jamiecheng/dab-radio-alarm/hardware/dab-radio-alarm.kicad_pcb

## KiCad design hardware/dab-radio-alarm.kicad_pcb (2023-07-09)

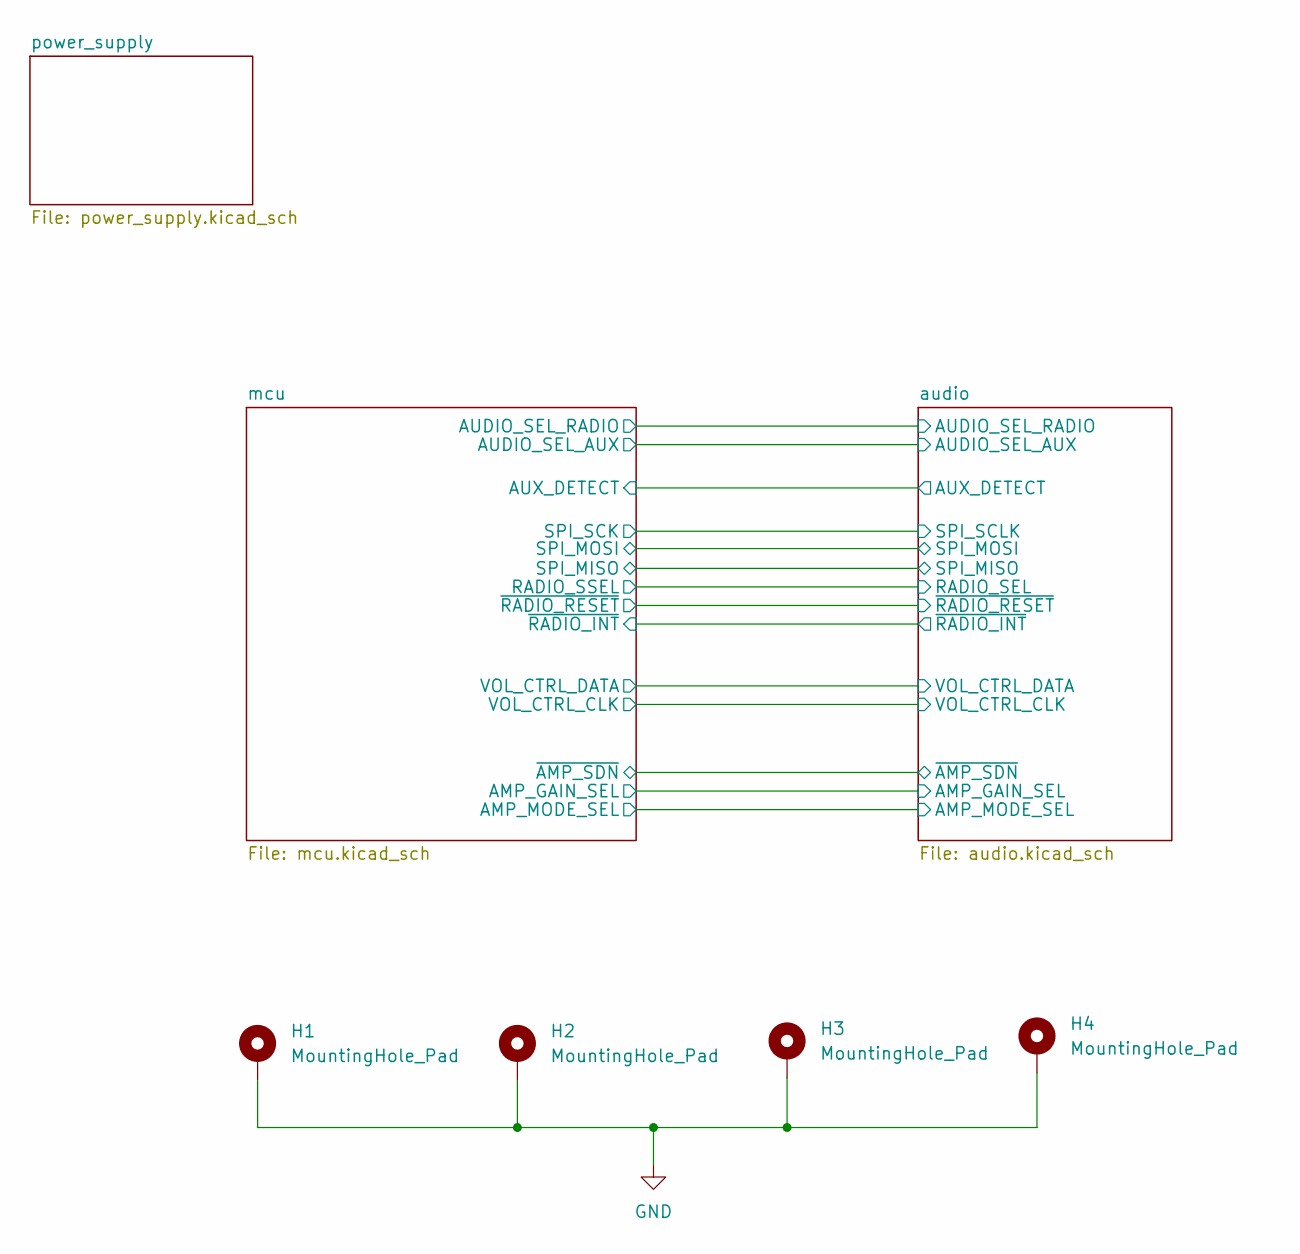
[picture p1: schematic dab-radio-alarm.kicad_sch]

Parts:
H1, H2, H3, H4: MountingHole_Pad; MountingHole_3.2mm_M3_Pad_Via

Connections:
GND: H1.1, H2.1, H3.1, H4.1; also elsewhere on the board

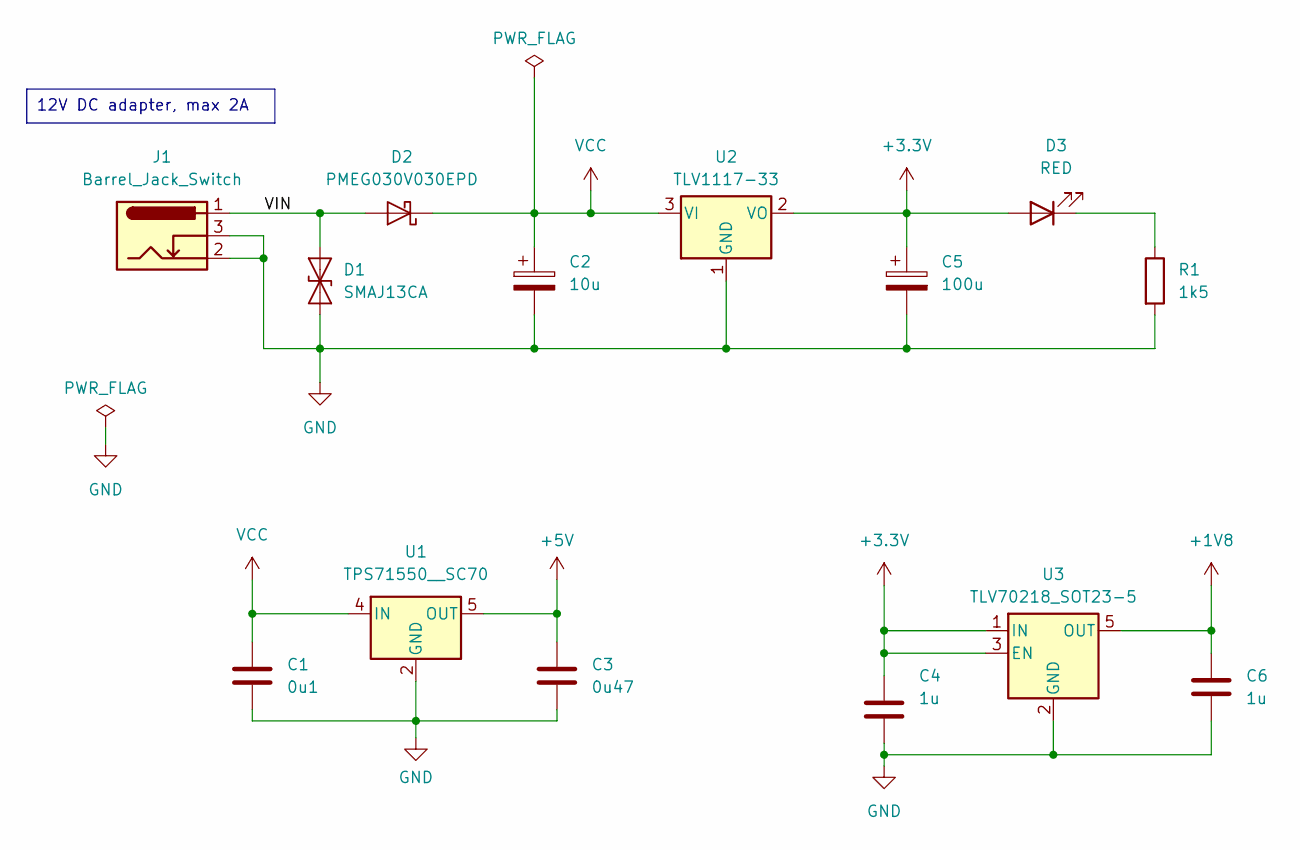
[picture p2: schematic power_supply.kicad_sch]

Parts:
C1: 0u1; C_0603_1608Metric
C2: 10u; CP_Elec_6.3x5.4
C3: 0u47; C_0402_1005Metric
C4, C6: 1u; C_0402_1005Metric
C5: 100u; CP_Elec_8x10
D1: SMAJ13CA; D_SMA
D2: PMEG030V030EPD; Nexperia_CFP15_SOT-1289
D3: RED; LED_0603_1608Metric
J1: Barrel_Jack_Switch; BarrelJack_GCT_DCJ200-10-A_Horizontal
R1: 1k5; R_0402_1005Metric
U1: TPS71550__SC70; SOT-353_SC-70-5
U2: TLV1117-33; SOT-223-3_TabPin2
U3: TLV70218_SOT23-5; SOT-23-5

Connections:
+1V8: C6.1, U3.5 (OUT); also elsewhere on the board
+3.3V: C4.1, C5.1, D3.2 (A), U2.2 (VO), U3.1 (IN), U3.3 (EN); also elsewhere on the board
+5V: C3.1, U1.5 (OUT); also elsewhere on the board
/power_supply/VIN: D1.1 (A1), D2.1 (A), D2.2 (A), J1.1
GND: C1.2, C2.2, C3.2, C4.2, C5.2, C6.2, D1.2 (A2), J1.2, J1.3, R1.2, U1.2 (GND), U2.1 (GND), U3.2 (GND); also elsewhere on the board
unnamed: D3.1 (K), R1.1
VCC: C1.1, C2.1, D2.3 (K), U1.4 (IN), U2.3 (VI); also elsewhere on the board

Notes on the sheet:
12V DC adapter, max 2A

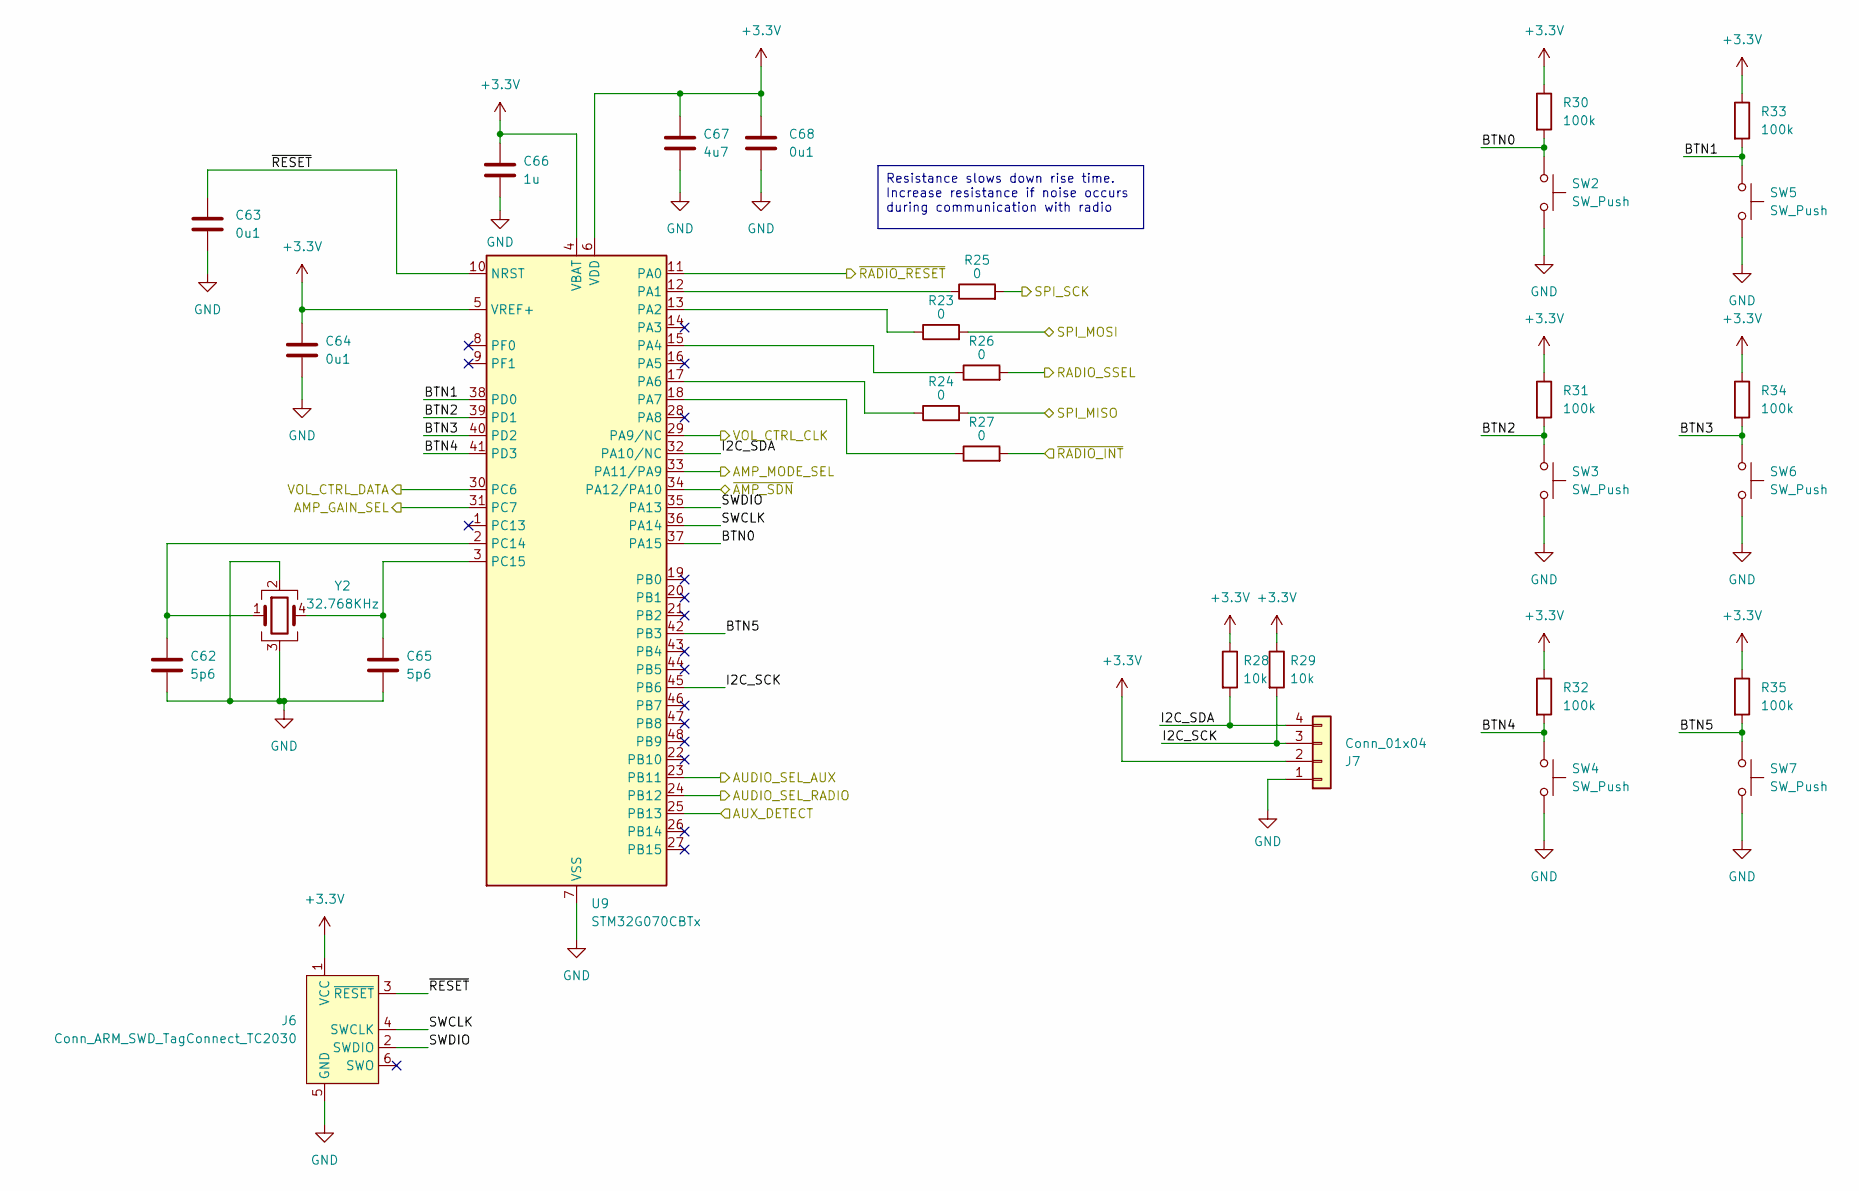
[picture p3: schematic mcu.kicad_sch]

Parts:
C62, C65: 5p6; C_0402_1005Metric
C63, C64, C68: 0u1; C_0402_1005Metric
C66: 1u; C_0402_1005Metric
C67: 4u7; C_0603_1608Metric
J6: Conn_ARM_SWD_TagConnect_TC2030; Tag-Connect_TC2030-IDC-FP_2x03_P1.27mm_Vertical
J7: Conn_01x04; PinHeader_1x04_P2.54mm_Vertical
R23, R24, R25, R26, R27: 0; R_0402_1005Metric
R28, R29: 10k; R_0402_1005Metric
R30, R31, R32, R33, R34, R35: 100k; R_0402_1005Metric
SW2, SW3, SW4, SW5, SW6, SW7: SW_Push; SW_PUSH_6mm_H5mm
U9: STM32G070CBTx; LQFP-48_7x7mm_P0.5mm
Y2: 32.768KHz; Crystal_SMD_3225-4Pin_3.2x2.5mm

Connections:
+3.3V: C64.1, C66.1, C67.1, C68.1, J6.1 (VCC), J7.2, R28.1, R29.1, R30.1, R31.1, R32.1, R33.1, R34.1, R35.1, U9.4 (VBAT), U9.5 (VREF+), U9.6 (VDD); also elsewhere on the board
/audio/AMP_GAIN_SEL: U9.31 (PC7); also elsewhere on the board
/audio/AMP_MODE_SEL: U9.33 (PA11/PA9); also elsewhere on the board
/audio/AUDIO_SEL_AUX: U9.23 (PB11); also elsewhere on the board
/audio/AUDIO_SEL_RADIO: U9.24 (PB12); also elsewhere on the board
/audio/AUX_DETECT: U9.25 (PB13); also elsewhere on the board
/audio/RADIO_SEL: R26.2; also elsewhere on the board
/audio/SPI_MISO: R24.2; also elsewhere on the board
/audio/SPI_MOSI: R23.2; also elsewhere on the board
/audio/SPI_SCLK: R25.2; also elsewhere on the board
/audio/VOL_CTRL_CLK: U9.29 (PA9/NC); also elsewhere on the board
/audio/VOL_CTRL_DATA: U9.30 (PC6); also elsewhere on the board
/audio/~AMP_SDN: U9.34 (PA12/PA10); also elsewhere on the board
/audio/~RADIO_INT: R27.2; also elsewhere on the board
/audio/~RADIO_RESET: U9.11 (PA0); also elsewhere on the board
/mcu/BTN0: R30.2, SW2.1, U9.37 (PA15)
/mcu/BTN1: R33.2, SW5.1, U9.38 (PD0)
/mcu/BTN2: R31.2, SW3.1, U9.39 (PD1)
/mcu/BTN3: R34.2, SW6.1, U9.40 (PD2)
/mcu/BTN4: R32.2, SW4.1, U9.41 (PD3)
/mcu/BTN5: R35.2, SW7.1, U9.42 (PB3)
/mcu/I2C_SCK: J7.3, R29.2, U9.45 (PB6)
/mcu/I2C_SDA: J7.4, R28.2, U9.32 (PA10/NC)
/mcu/SWCLK: J6.4 (SWCLK), U9.36 (PA14)
/mcu/SWDIO: J6.2 (SWDIO), U9.35 (PA13)
/mcu/~RESET: C63.1, J6.3 (~RESET), U9.10 (NRST)
GND: C62.2, C63.2, C64.2, C65.2, C66.2, C67.2, C68.2, J6.5 (GND), J7.1, SW2.2, SW3.2, SW4.2, SW5.2, SW6.2, SW7.2, U9.7 (VSS), Y2.2, Y2.3; also elsewhere on the board
unnamed: R25.1, U9.12 (PA1)
unnamed: R23.1, U9.13 (PA2)
unnamed: R26.1, U9.15 (PA4)
unnamed: R24.1, U9.17 (PA6)
unnamed: R27.1, U9.18 (PA7)
unnamed: C62.1, U9.2 (PC14), Y2.1
unnamed: C65.1, U9.3 (PC15), Y2.4

Notes on the sheet:
Resistance slows down rise time. Increase resistance if noise occurs during communication with radio

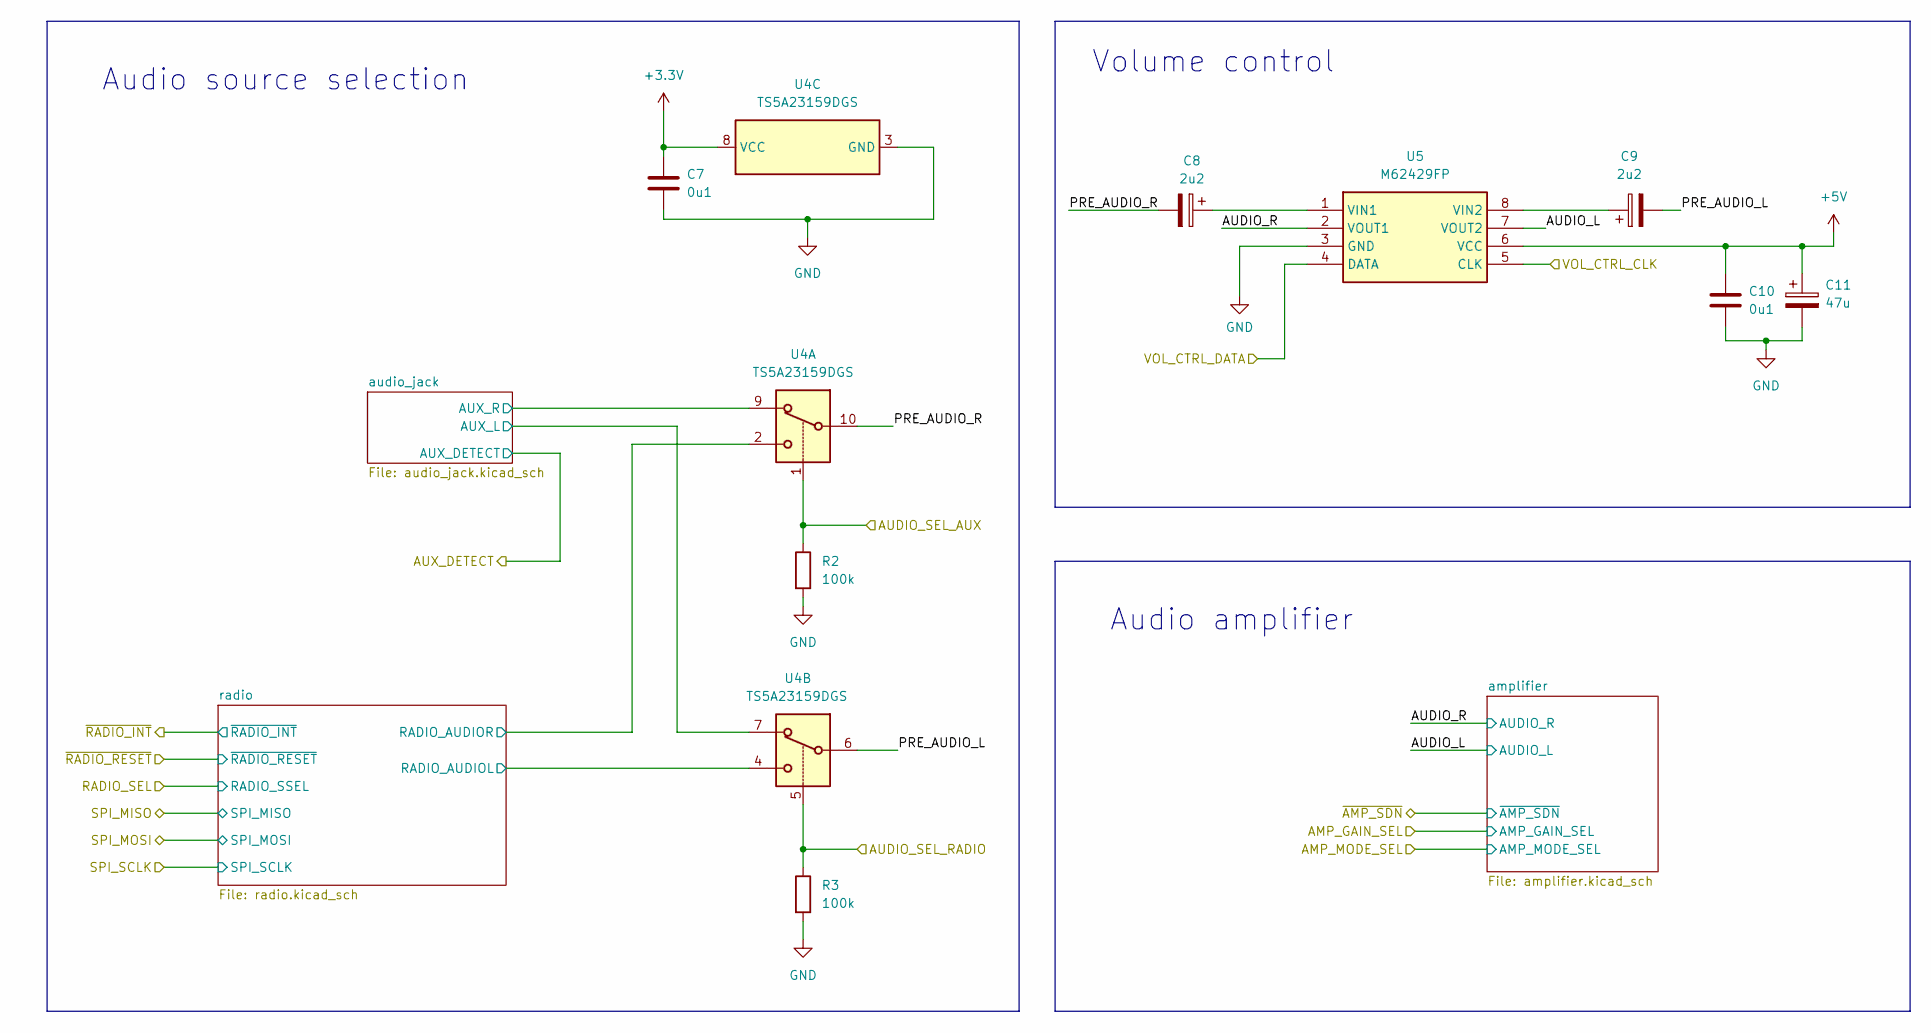
[picture p4: schematic audio.kicad_sch]

Parts:
C7, C10: 0u1; C_0402_1005Metric
C8, C9: 2u2; CP_Elec_4x5.4
C11: 47u; CP_Elec_5x5.4
R2, R3: 100k; R_0402_1005Metric
U4: TS5A23159DGS; VSSOP-10_3x3mm_P0.5mm
U5: M62429FP; SOP-8_3.9x4.9mm_P1.27mm; Manufacturer_Part_Number M62429FP

Connections:
+3.3V: C7.1, U4.8 (VCC); also elsewhere on the board
+5V: C10.1, C11.1, U5.6 (VCC); also elsewhere on the board
/audio/AUDIO_L: U5.7 (VOUT2); also elsewhere on the board
/audio/AUDIO_R: U5.2 (VOUT1); also elsewhere on the board
/audio/AUDIO_SEL_AUX: R2.1, U4.1; also elsewhere on the board
/audio/AUDIO_SEL_RADIO: R3.1, U4.5; also elsewhere on the board
/audio/PRE_AUDIO_L: C9.2, U4.6
/audio/PRE_AUDIO_R: C8.2, U4.10
/audio/VOL_CTRL_CLK: U5.5 (CLK); also elsewhere on the board
/audio/VOL_CTRL_DATA: U5.4 (DATA); also elsewhere on the board
/audio/audio_jack/AUX_L: U4.7; also elsewhere on the board
/audio/audio_jack/AUX_R: U4.9; also elsewhere on the board
/audio/radio/RADIO_AUDIOL: U4.4; also elsewhere on the board
/audio/radio/RADIO_AUDIOR: U4.2; also elsewhere on the board
GND: C7.2, C10.2, C11.2, R2.2, R3.2, U4.3 (GND), U5.3 (GND); also elsewhere on the board
unnamed: C8.1, U5.1 (VIN1)
unnamed: C9.1, U5.8 (VIN2)

Notes on the sheet:
Volume control
Audio amplifier
Audio source selection

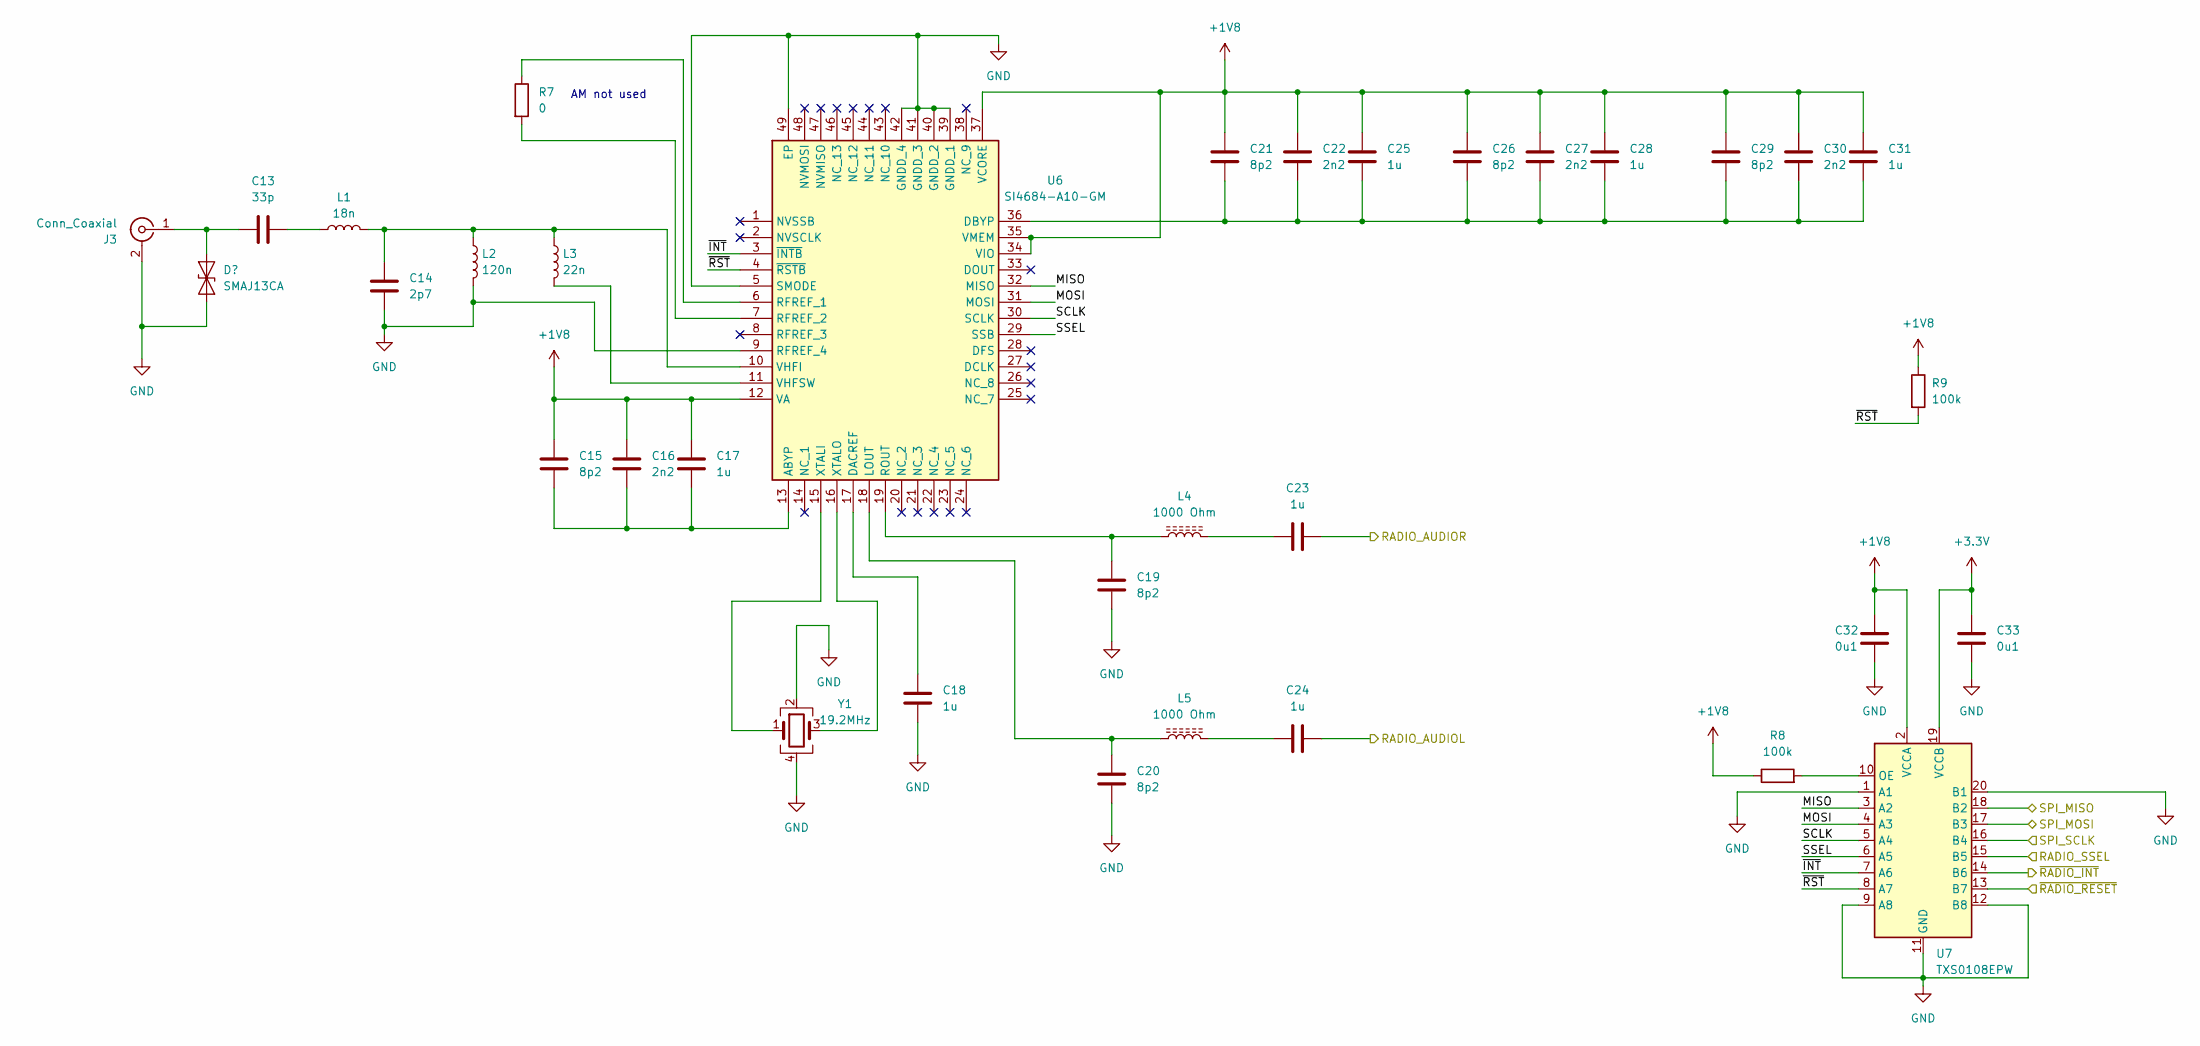
[picture p5: schematic radio.kicad_sch]

Parts:
C13: 33p; C_0402_1005Metric
C14: 2p7; C_0402_1005Metric
C15, C19, C20, C21, C26, C29: 8p2; C_0402_1005Metric
C16, C22, C27, C30: 2n2; C_0402_1005Metric
C17, C18, C23, C24, C25, C28, C31: 1u; C_0402_1005Metric
C32, C33: 0u1; C_0402_1005Metric
D7: SMAJ13CA; D_SMA
J3: Conn_Coaxial; SMA_Molex_73251-1153_EdgeMount_Horizontal
L1: 18n; L_0402_1005Metric
L2: 120n; L_0402_1005Metric
L3: 22n; L_0402_1005Metric
L4, L5: 1000 Ohm; L_0402_1005Metric
R7: 0; R_0402_1005Metric
R8, R9: 100k; R_0402_1005Metric
U6: SI4684-A10-GM; NXP_LQFN-48-1EP_7x7mm_P0.5mm_EP3.5x3.5mm_16xMask0.45x0.45; Manufacturer_Part_Number SI4684-A10-GM; Mouser Part Number 634-SI4684-A10-GM
U7: TXS0108EPW; TSSOP-20_4.4x6.5mm_P0.65mm
Y1: 19.2MHz; Crystal_SMD_EuroQuartz_MT-4Pin_3.2x2.5mm

Connections:
+1V8: C15.1, C16.1, C17.1, C21.1, C22.1, C25.1, C26.1, C27.1, C28.1, C29.1, C30.1, C31.1, C32.1, R8.1, R9.1, U6.12 (VA), U6.34 (VIO), U6.35 (VMEM), U6.37 (VCORE), U7.2 (VCCA); also elsewhere on the board
+3.3V: C33.1, U7.19 (VCCB); also elsewhere on the board
/audio/RADIO_SEL: U7.15 (B5); also elsewhere on the board
/audio/SPI_MISO: U7.18 (B2); also elsewhere on the board
/audio/SPI_MOSI: U7.17 (B3); also elsewhere on the board
/audio/SPI_SCLK: U7.16 (B4); also elsewhere on the board
/audio/radio/MISO: U6.32 (MISO), U7.3 (A2)
/audio/radio/MOSI: U6.31 (MOSI), U7.4 (A3)
/audio/radio/RADIO_AUDIOL: C24.2; also elsewhere on the board
/audio/radio/RADIO_AUDIOR: C23.2; also elsewhere on the board
/audio/radio/SCLK: U6.30 (SCLK), U7.5 (A4)
/audio/radio/SSEL: U6.29 (SSB), U7.6 (A5)
/audio/radio/~INT: U6.3 (~INTB), U7.7 (A6)
/audio/radio/~RST: R9.2, U6.4 (~RSTB), U7.8 (A7)
/audio/~RADIO_INT: U7.14 (B6); also elsewhere on the board
/audio/~RADIO_RESET: U7.13 (B7); also elsewhere on the board
GND: C14.2, C18.2, C19.2, C20.2, C32.2, C33.2, D7.2 (A2), J3.2 (Ext), L2.2, U6.5 (SMODE), U6.9 (RFREF_4), U6.39 (GNDD_1), U6.40 (GNDD_2), U6.41 (GNDD_3), U6.42 (GNDD_4), U6.49 (EP), U7.1 (A1), U7.9 (A8), U7.11 (GND), U7.12 (B8), U7.20 (B1), Y1.2, Y1.4; also elsewhere on the board
unnamed: C13.2, L1.1
unnamed: C23.1, L4.2
unnamed: C24.1, L5.2
unnamed: C13.1, D7.1 (A1), J3.1 (In)
unnamed: C15.2, C16.2, C17.2, U6.13 (ABYP)
unnamed: C18.1, U6.17 (DACREF)
unnamed: C21.2, C22.2, C25.2, C26.2, C27.2, C28.2, C29.2, C30.2, C31.2, U6.36 (DBYP)
unnamed: C20.1, L5.1, U6.18 (LOUT)
unnamed: R7.1, U6.6 (RFREF_1)
unnamed: R7.2, U6.7 (RFREF_2)
unnamed: C19.1, L4.1, U6.19 (ROUT)
unnamed: C14.1, L1.2, L2.1, L3.1, U6.10 (VHFI)
unnamed: L3.2, U6.11 (VHFSW)
unnamed: U6.15 (XTALI), Y1.1
unnamed: U6.16 (XTALO), Y1.3
unnamed: R8.2, U7.10 (OE)

Notes on the sheet:
AM not used

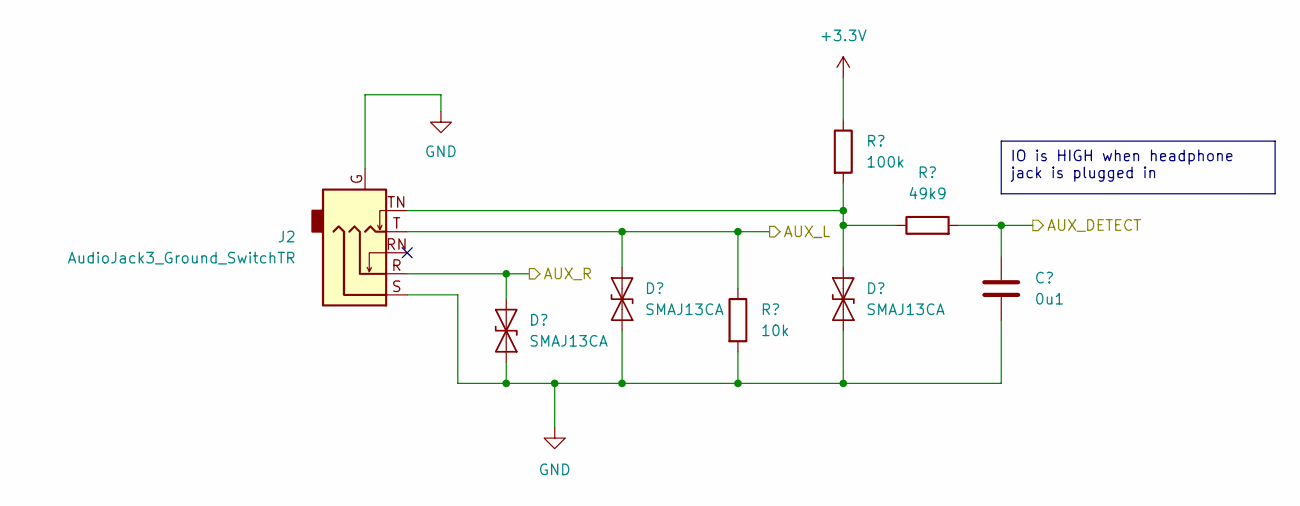
[picture p6: schematic audio_jack.kicad_sch]

Parts:
C12: 0u1; C_0402_1005Metric
D4, D5, D6: SMAJ13CA; D_SMA
J2: AudioJack3_Ground_SwitchTR; Jack_3.5mm_PJ31060-I_Horizontal_1
R4: 10k; R_0402_1005Metric
R5: 100k; R_0402_1005Metric
R6: 49k9; R_0402_1005Metric

Connections:
+3.3V: R5.1; also elsewhere on the board
/audio/AUX_DETECT: C12.1, R6.2; also elsewhere on the board
/audio/audio_jack/AUX_L: D5.1 (A1), J2.T, R4.1; also elsewhere on the board
/audio/audio_jack/AUX_R: D4.1 (A1), J2.R; also elsewhere on the board
GND: C12.2, D4.2 (A2), D5.2 (A2), D6.2 (A2), J2.G, J2.S, R4.2; also elsewhere on the board
unnamed: D6.1 (A1), J2.TN, R5.2, R6.1

Notes on the sheet:
IO is HIGH when headphone jack is plugged in

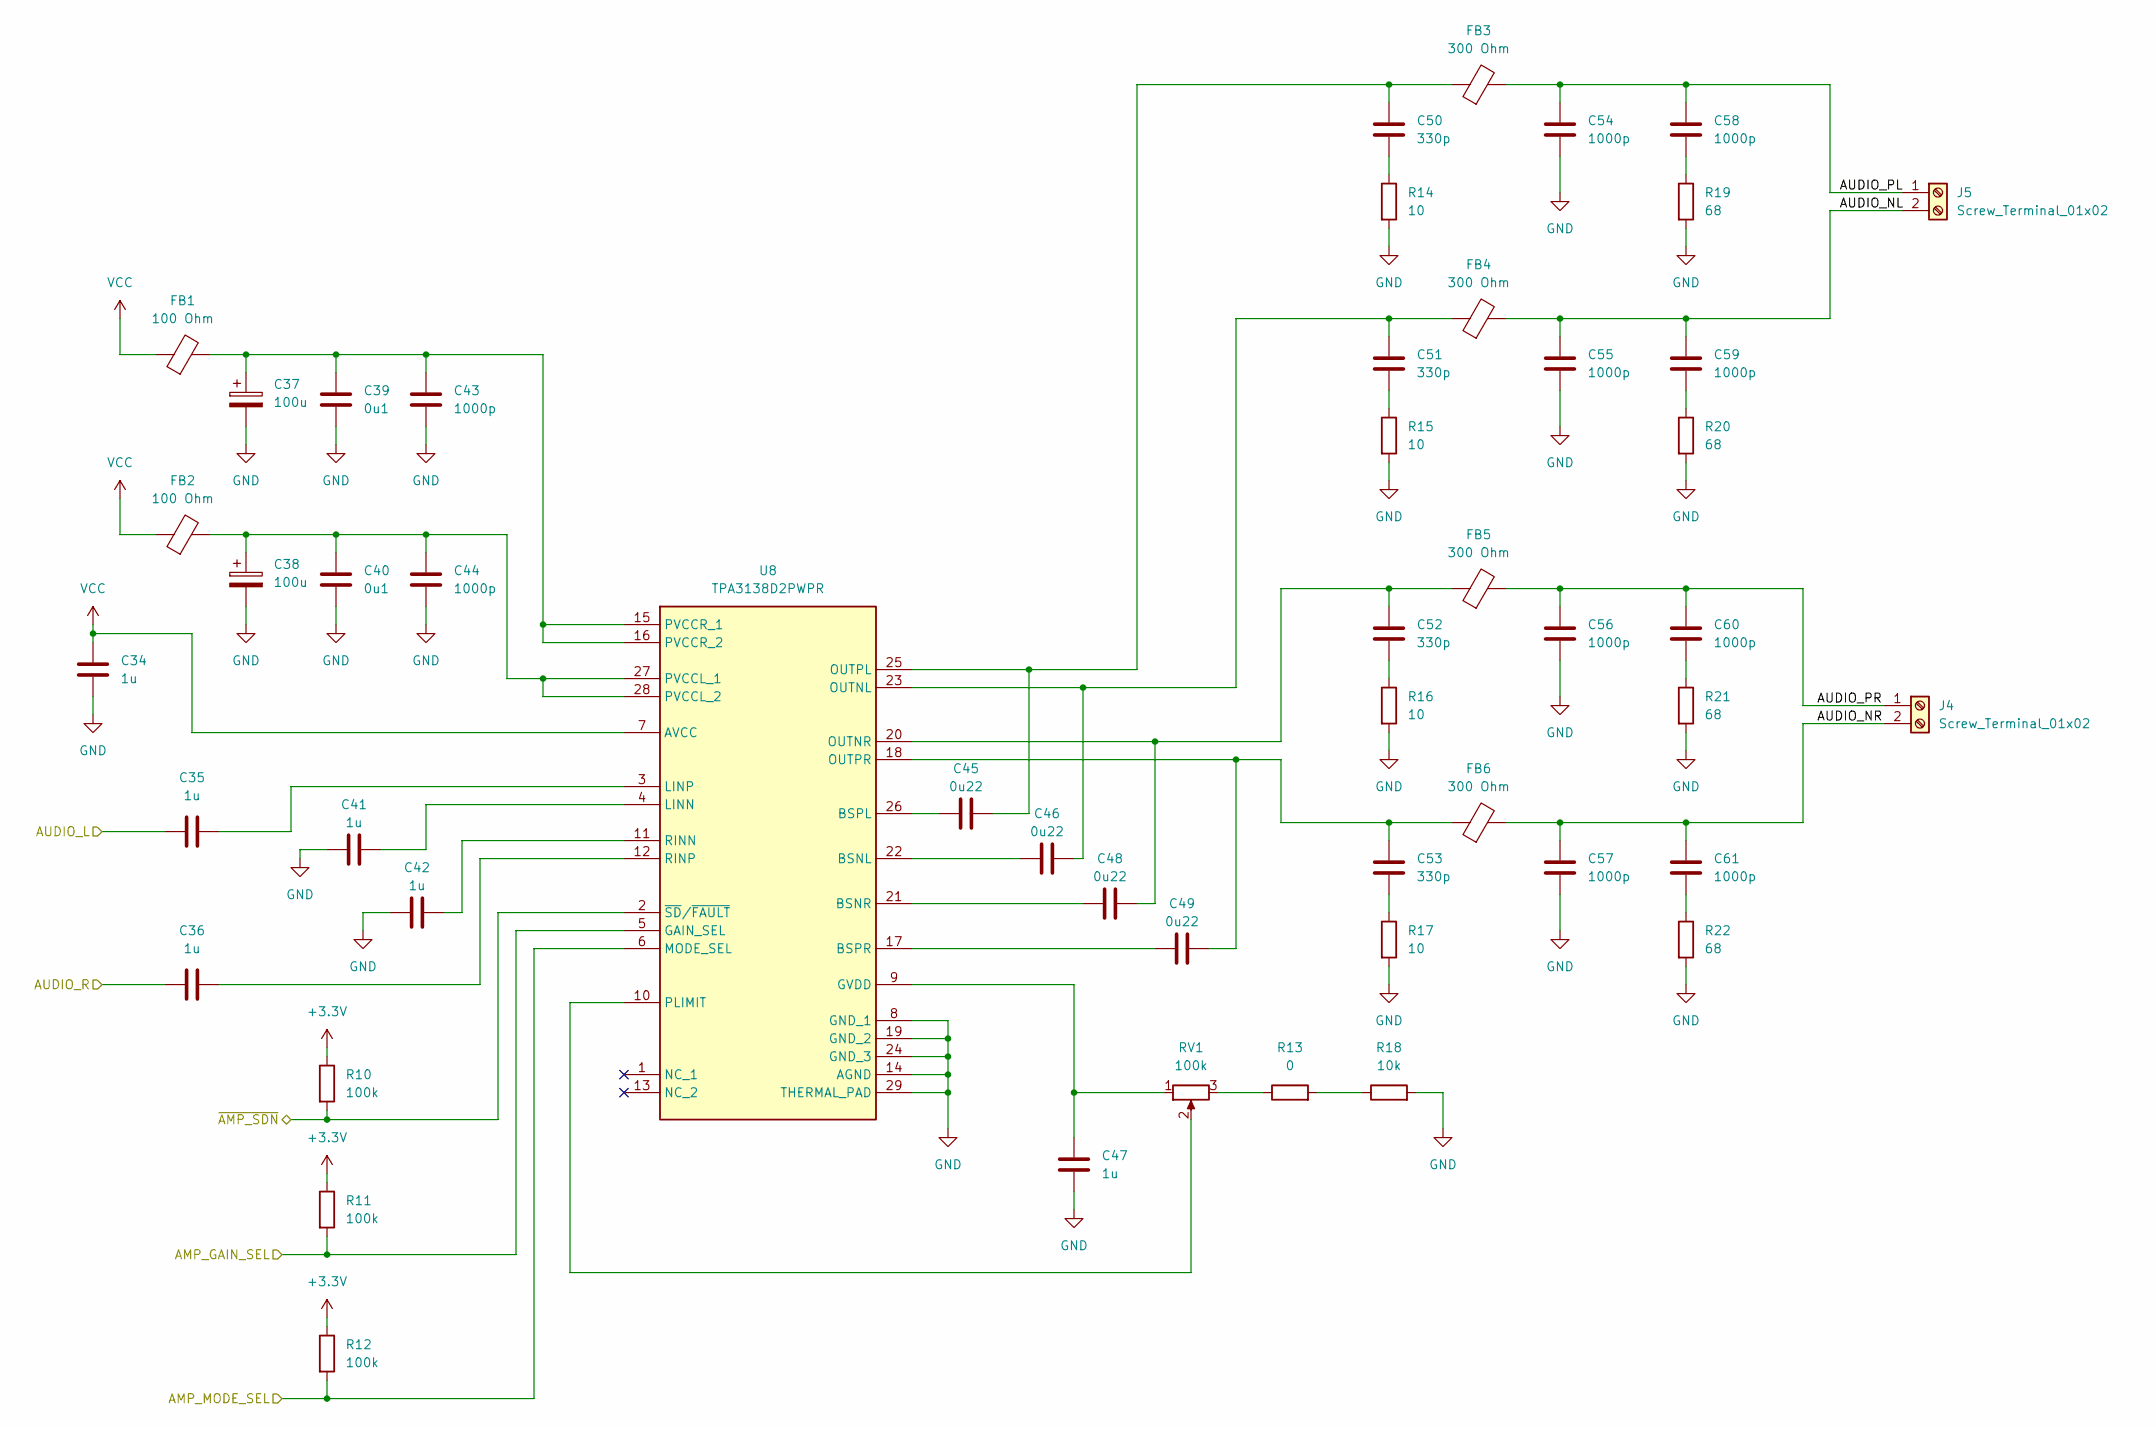
[picture p7: schematic amplifier.kicad_sch]

Parts:
C34, C35, C36, C41, C42, C47: 1u; C_0603_1608Metric
C37, C38: 100u; CP_Elec_8x10
C39, C40: 0u1; C_0603_1608Metric
C43, C44, C54, C55, C56, C57, C58, C59, C60, C61: 1000p; C_0603_1608Metric
C45, C46, C48, C49: 0u22; C_0603_1608Metric
C50, C51, C52, C53: 330p; C_0603_1608Metric
FB1, FB2: 100 Ohm; L_0805_2012Metric
FB3, FB4, FB5, FB6: 300 Ohm; L_0805_2012Metric
J4, J5: Screw_Terminal_01x02; TerminalBlock_MetzConnect_Type011_RT05502HBWC_1x02_P5.00mm_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
R10, R11, R12: 100k; R_0402_1005Metric
R13: 0; R_0402_1005Metric
R14, R15, R16, R17: 10; R_0603_1608Metric
R18: 10k; R_0402_1005Metric
R19, R20, R21, R22: 68; R_0603_1608Metric
RV1: 100k; Potentiometer_Bourns_3314G_Vertical
U8: TPA3138D2PWPR; HTSSOP-28-1EP_4.4x9.7mm_P0.65mm_EP2.85x5.4mm_ThermalVias; Manufacturer_Part_Number TPA3138D2PWPR; Mouser Part Number 595-TPA3138D2PWPR

Connections:
+3.3V: R10.1, R11.1, R12.1; also elsewhere on the board
/audio/AMP_GAIN_SEL: R11.2, U8.5 (GAIN_SEL); also elsewhere on the board
/audio/AMP_MODE_SEL: R12.2, U8.6 (MODE_SEL); also elsewhere on the board
/audio/AUDIO_L: C35.1; also elsewhere on the board
/audio/AUDIO_R: C36.1; also elsewhere on the board
/audio/amplifier/AUDIO_NL: C55.1, C59.1, FB4.2, J5.2
/audio/amplifier/AUDIO_NR: C57.1, C61.1, FB6.2, J4.2
/audio/amplifier/AUDIO_PL: C54.1, C58.1, FB3.2, J5.1
/audio/amplifier/AUDIO_PR: C56.1, C60.1, FB5.2, J4.1
/audio/~AMP_SDN: R10.2, U8.2 (~SD/~FAULT); also elsewhere on the board
GND: C34.2, C37.2, C38.2, C39.2, C40.2, C41.1, C42.1, C43.2, C44.2, C47.2, C54.2, C55.2, C56.2, C57.2, R14.2, R15.2, R16.2, R17.2, R18.2, R19.2, R20.2, R21.2, R22.2, U8.8 (GND_1), U8.14 (AGND), U8.19 (GND_2), U8.24 (GND_3), U8.29 (THERMAL_PAD); also elsewhere on the board
unnamed: C50.2, R14.1
unnamed: C51.2, R15.1
unnamed: C52.2, R16.1
unnamed: C53.2, R17.1
unnamed: C58.2, R19.1
unnamed: C59.2, R20.1
unnamed: C60.2, R21.1
unnamed: C61.2, R22.1
unnamed: R13.1, RV1.3
unnamed: R13.2, R18.1
unnamed: C46.1, U8.22 (BSNL)
unnamed: C48.1, U8.21 (BSNR)
unnamed: C45.1, U8.26 (BSPL)
unnamed: C49.1, U8.17 (BSPR)
unnamed: C47.1, RV1.1, U8.9 (GVDD)
unnamed: C41.2, U8.4 (LINN)
unnamed: C35.2, U8.3 (LINP)
unnamed: C46.2, C51.1, FB4.1, U8.23 (OUTNL)
unnamed: C48.2, C52.1, FB5.1, U8.20 (OUTNR)
unnamed: C45.2, C50.1, FB3.1, U8.25 (OUTPL)
unnamed: C49.2, C53.1, FB6.1, U8.18 (OUTPR)
unnamed: RV1.2, U8.10 (PLIMIT)
unnamed: C38.1, C40.1, C44.1, FB2.2, U8.27 (PVCCL_1), U8.28 (PVCCL_2)
unnamed: C37.1, C39.1, C43.1, FB1.2, U8.15 (PVCCR_1), U8.16 (PVCCR_2)
unnamed: C42.2, U8.11 (RINN)
unnamed: C36.2, U8.12 (RINP)
VCC: C34.1, FB1.1, FB2.1, U8.7 (AVCC); also elsewhere on the board

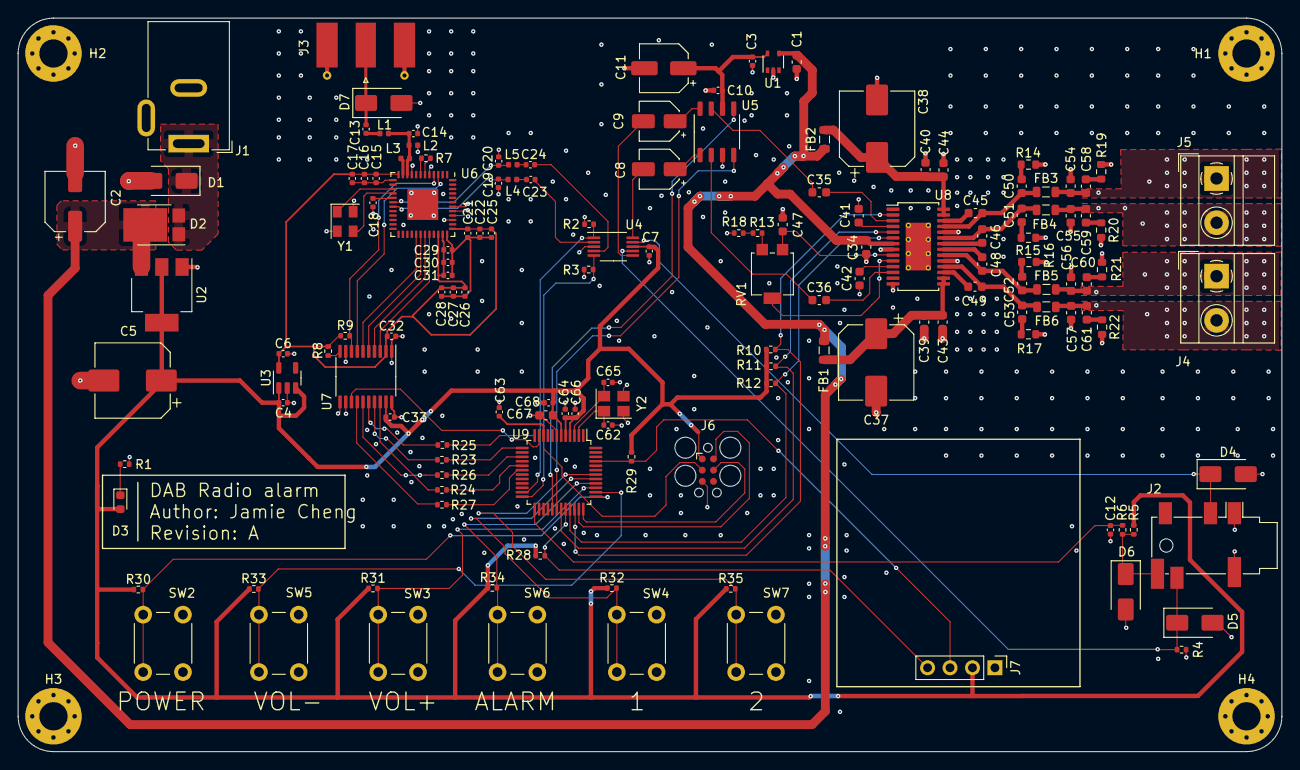
[picture p8: board dab-radio-alarm.kicad_pcb from above]

Board: 4 copper layers, 143.0 x 83.0 mm, 150 parts (0 on the bottom side), 102 nets.
