jamiecheng/dab-radio-alarm/firmware/firmware.ioc

Mcu.UserName=STM32G070CBTx
PA0.GPIO_Label=RADIO_RESET
PA0.Signal=GPIO_Output
PA1.Signal=SPI1_SCK
PA10.Signal=I2C1_SDA
PA13.Signal=SYS_SWDIO
PA14-BOOT0.Signal=SYS_SWCLK
PA15.GPIO_Label=BT0
PA15.Signal=GPIO_Input
PA2.Signal=SPI1_MOSI
PA4.Signal=SPI1_NSS
PA6.Signal=SPI1_MISO
PA7.GPIO_Label=RADIO_INT
PA7.Signal=GPIO_Input
PA9.GPIO_Label=VOL_CTRL_CLK
PA9.Signal=GPIO_Output
PB11.GPIO_Label=AUDIO_SEL_AUX
PB11.Signal=GPIO_Output
PB12.GPIO_Label=AUDIO_SEL_RADIO
PB12.Signal=GPIO_Output
PB13.GPIO_Label=AUX_DETECT
PB13.Signal=GPIO_Input
PB3.GPIO_Label=BT5
PB3.Signal=GPIO_Input
PB6.Signal=I2C1_SCL
PC6.GPIO_Label=VOL_CTRL_DATA
PC6.Signal=GPIO_Output
PC7.GPIO_Label=AMP_GAIN_SEL
PC7.Signal=GPIO_Output
PD0.GPIO_Label=BT1
PD0.Signal=GPIO_Input
PD1.GPIO_Label=BT2
PD1.Signal=GPIO_Input
PD2.GPIO_Label=BT3
PD2.Signal=GPIO_Input
PD3.GPIO_Label=BT4
PD3.Signal=GPIO_Input
